Ezic1/CTRL-LEDs_12F1822/02_Mechanical/Disipador.FCStd

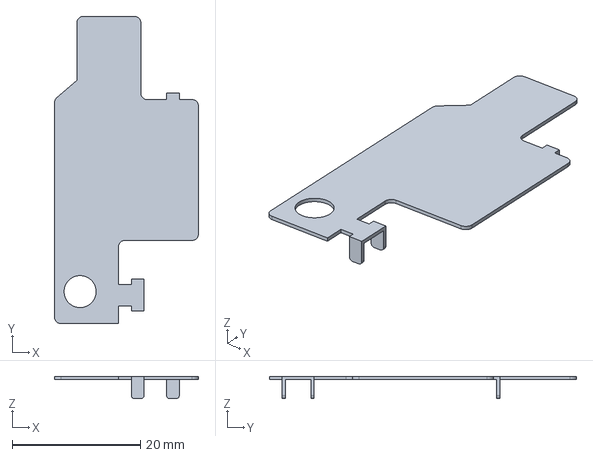
[picture p1: CAD file, 2026-11-11]
02_Mechanical/Disipador.FCStd
22.5 x 48.0 x 3.50 mm
