Ezic1/CTRL-LEDs_12F1822/(list of files, cad)

Other CAD files:
02_Mechanical/exports/Disipador-Cuerpo.step
