Ezic1/CTRL-LEDs_12F1822/01_PCB-CTRL-LEDs/CTRL-LEDs.kicad_pcb

## KiCad design 01_PCB-CTRL-LEDs/CTRL-LEDs.kicad_pcb (2026-11-11)

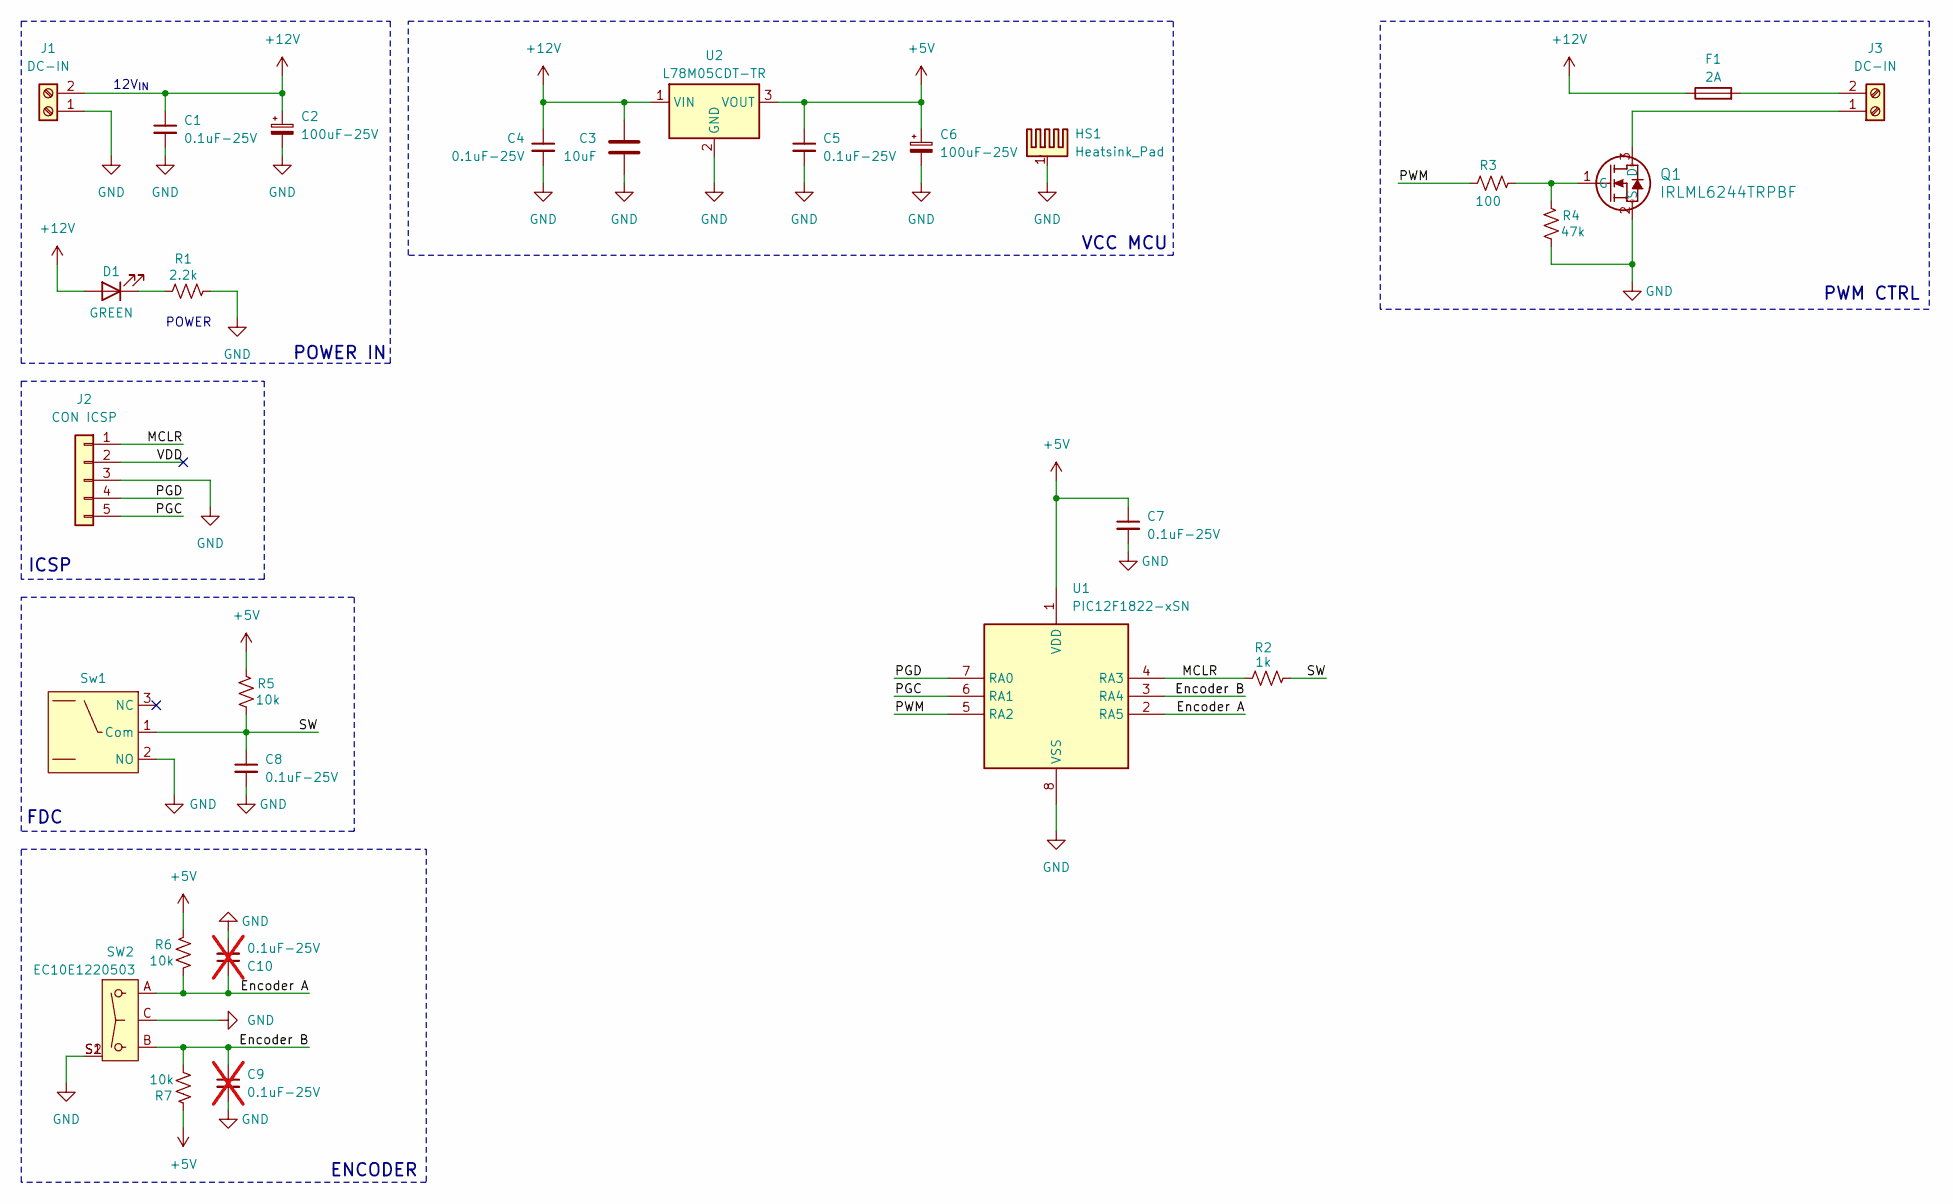
[picture p2: schematic CTRL-LEDs.kicad_sch, Main Control LEDs]

Parts:
C1, C4, C5, C7, C8: 0.1uF-25V; C_0805_2012Metric_Pad1.18x1.45mm_HandSolder; MPN CL10B104KA8NNNC
C2, C6: 100uF-25V; CP_Radial_D10.0mm_P5.00mm
C3: 10uF; C_0805_2012Metric_Pad1.18x1.45mm_HandSolder
C9, C10: 0.1uF-25V; C_0805_2012Metric_Pad1.18x1.45mm_HandSolder; MPN CL10B104KA8NNNC; not fitted
D1: GREEN; LED_D3.0mm
F1: 2A; 1206_HandSolder
HS1: Heatsink_Pad; Disipador
J1, J3: DC-IN; TerminalBlock_1x02_P5.00mm
J2: CON ICSP; PinSocket_1x05_P2.54mm_Vertical
Q1: IRLML6244TRPBF
R1: 2.2k; 0805_HandSolder
R2: 1k; 0805_HandSolder
R3: 100; 0805_HandSolder
R4: 47k; 0805_HandSolder
R5, R6, R7: 10k; 0805_HandSolder
SW2: EC10E1220503; CONN03_EC10E_9P8X6P1_ALPS; MPN EC10E1220503
Sw1: DM3CQF1003L04; Switch SPDT_standard
U1: PIC12F1822-xSN; SOIC-8_3.9x4.9mm_P1.27mm
U2: L78M05CDT-TR; VREG_L78M05CDT-TR; MPN L78M05CDT-TR

Connections:
+5V: C5.1, C6.1, C7.1, R5.2, R6.2, R7.2, U1.1 (VDD), U2.3 (VOUT)
+12V: C1.1, C2.1, C3.1, C4.1, D1.2 (A), F1.1, J1.2, U2.1 (VIN)
/Encoder A: C10.1, R6.1, SW2.A, U1.2 (RA5)
/Encoder B: C9.1, R7.1, SW2.B, U1.3 (RA4)
/MCLR: J2.1, R2.1, U1.4 (RA3)
/PGC: J2.5, U1.6 (RA1)
/PGD: J2.4, U1.7 (RA0)
/PWM: R3.1, U1.5 (RA2)
/SW: C8.1, R2.2, R5.1, Sw1.1 (Com)
/VDD: J2.2
GND: C1.2, C2.2, C3.2, C4.2, C5.2, C6.2, C7.2, C8.2, C9.2, C10.2, HS1.1, J1.1, J2.3, Q1.2 (S), R1.2, R4.1, SW2.C, SW2.S1, SW2.S2, Sw1.2 (NO), U1.8 (VSS), U2.2 (GND)
unnamed: D1.1 (K), R1.1
unnamed: J3.1, Q1.3 (D)
unnamed: F1.2, J3.2
unnamed: Q1.1 (G), R3.2, R4.2

Notes on the sheet:
FDC
ENCODER
12V_{IN}
POWER IN
POWER
PWM CTRL
VCC MCU
ICSP

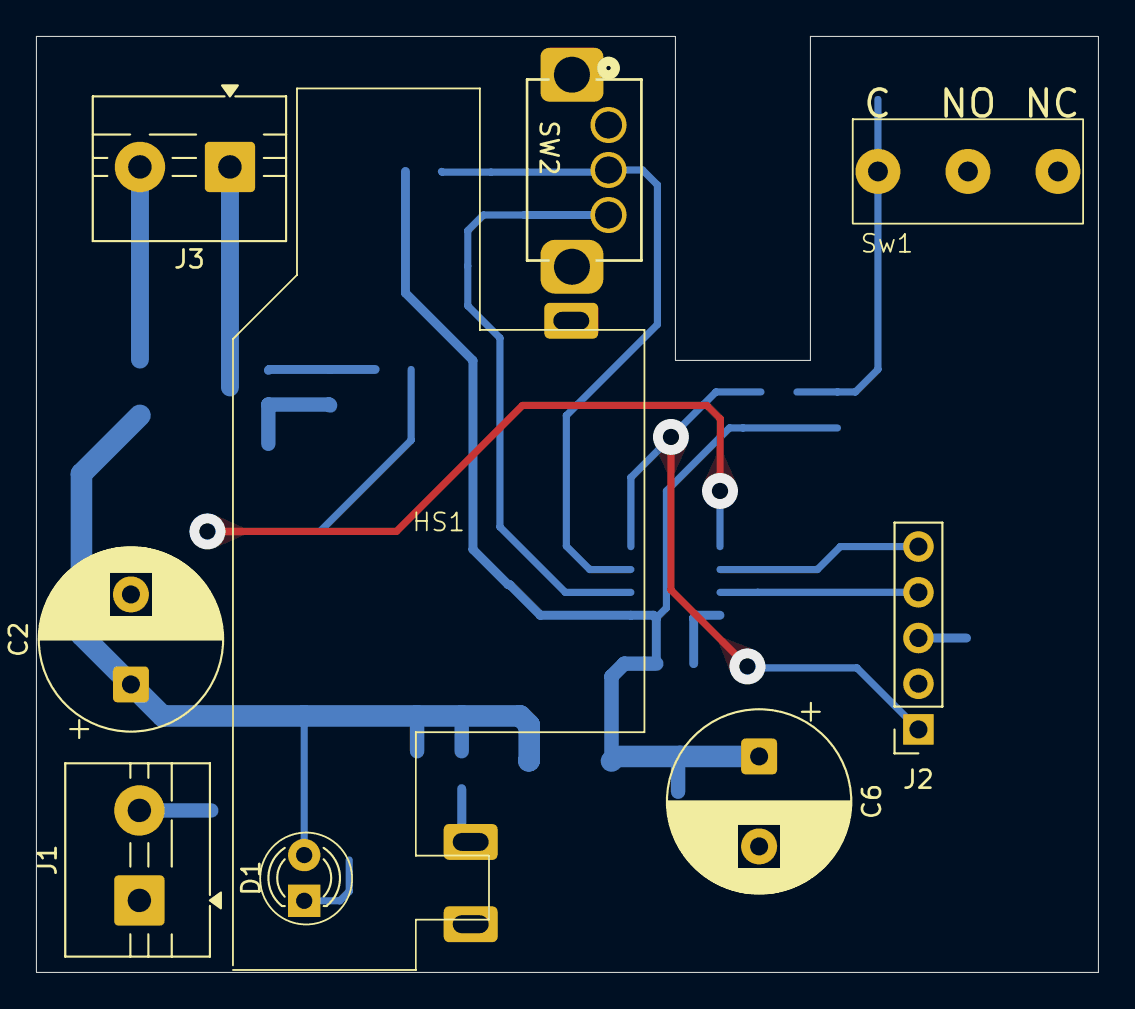
[picture p3: board CTRL-LEDs.kicad_pcb from above]

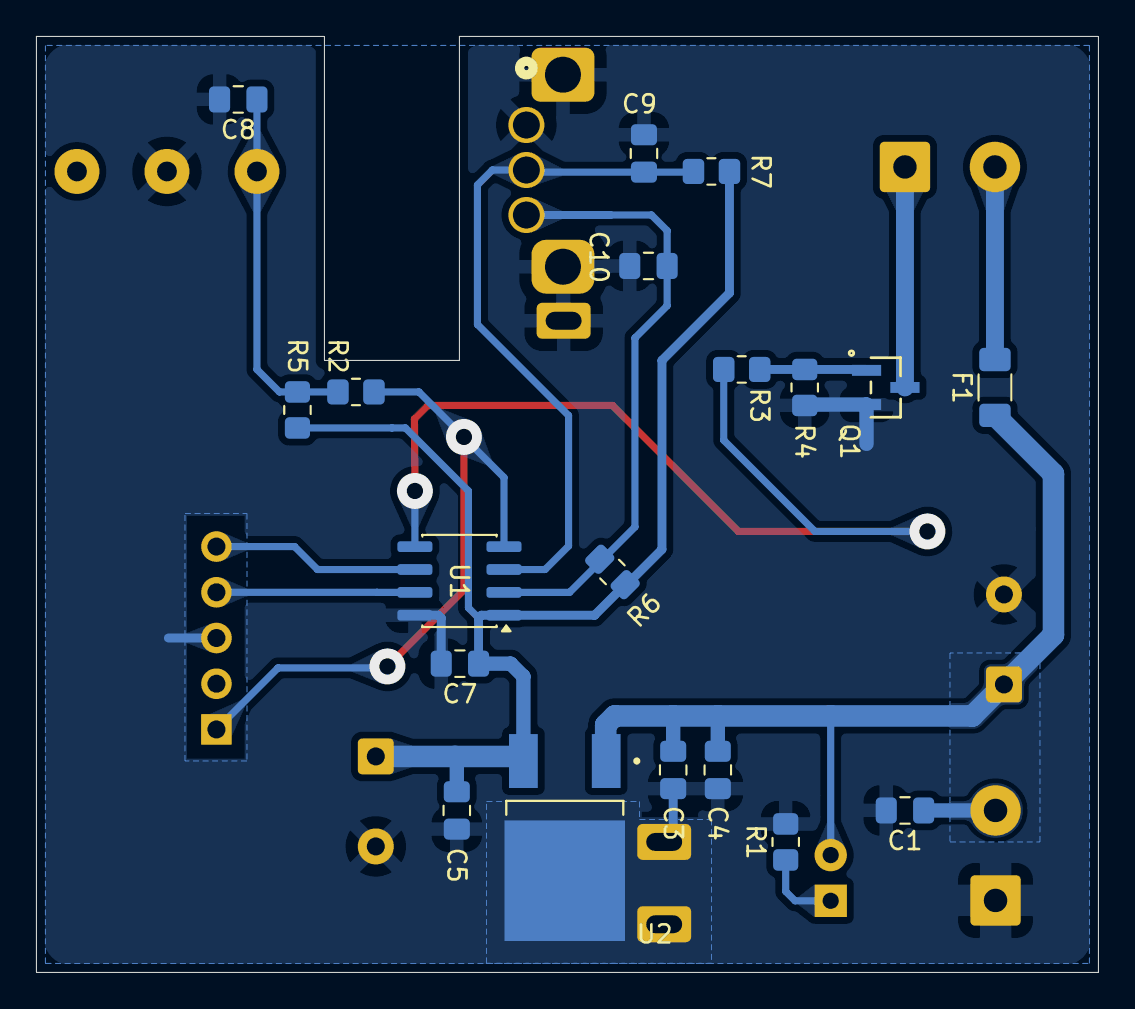
[picture p4: board CTRL-LEDs.kicad_pcb from below]

Board: 2 copper layers, 59.0 x 52.0 mm, 28 parts (19 on the bottom side), 14 nets.
